niccolascassel/saorafael/README.md

saorafael
=========

São Rafael allotment's projects
