niccolascassel/saorafael/Documentation/ART_ São_Rafael_Nova.pdf

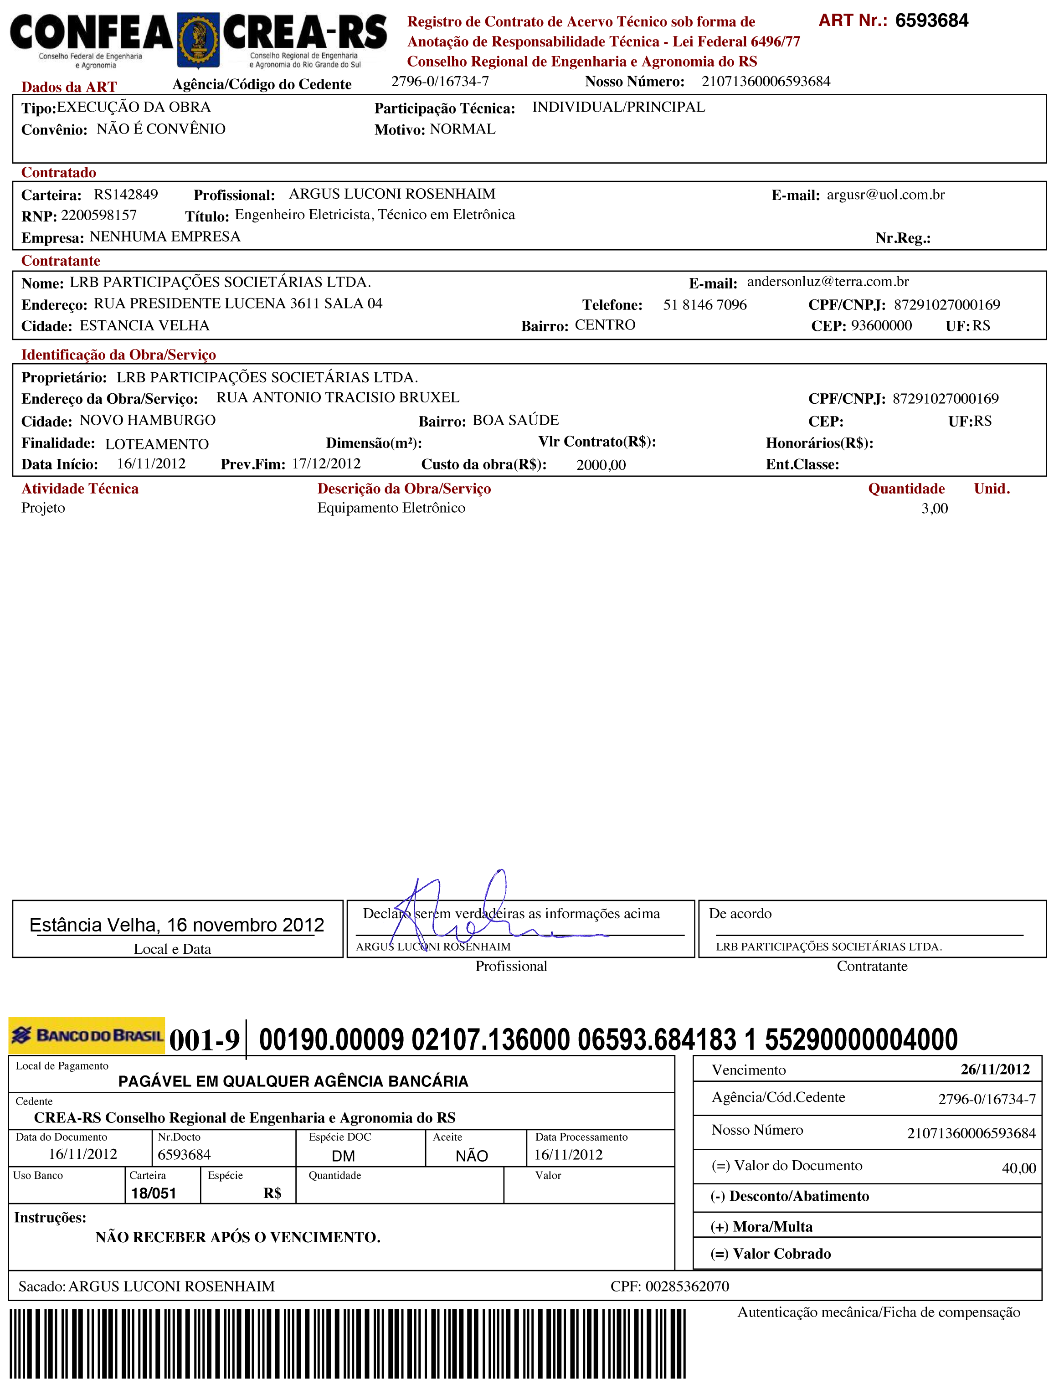
[picture p7: page 1]
