niccolascassel/saorafael/Documentation/Sewage III/Carga Instalada.xlsx

Tipo | Tensão Nominal | Tipo de Rede | Potência Nominal | Quantidade | Potência Total
Lâmpada Compacta | 220Vac | Monofásica | 100 W | 2 | 200 W
Lâmpada de Vapor Sódio | 220Vac | Monofásica | 0.50 kW | 19 | 9.50 kW
Tomada de Uso Geral | 220Vac | Monofásica | 300 W | 3 | 900 W
Painel de Acionamento | 380Vac | Trifásica | 1.50 kW | 5 | 7.50 kW
Misturador Submerso | 380Vac | Trifásica | 2.76 kW | 2 | 5.52 kW
Bomba Helicoidal | 380Vac | Trifásica | 1.42 kW | 1 | 1.42 kW
Bomba Centrífuga Submersível | 380Vac | Trifásica | 6.65 kW | 2 | 13.30 kW
Soprador | 380Vac | Trifásica | 17.73 kW | 1 | 17.73 kW
Bomba Dosadora com Diafragma | 380Vac | Trifásica | 0.45 kW | 2 | 0.90 kW
 |  |  |  | Carga Total Instalada | 56.97 kW
* A potência nominal dos motores foi alculada usando a tabela de rendimento e fator de potência da WEG
