niccolascassel/saorafael/Documentation/Sewage I & II/Carga Instalada - Desatualizada.xlsx

Tipo | Tensão Nominal | Tipo de Rede | Potência Nominal | Quantidade | Potência Total
Lâmpada Compacta | 220Vac | Monofásica | 100 W | 2 | 200 W
Lâmpada de Vapor Sódio | 220Vac | Monofásica | 0.50 kW | 9 | 4.50 kW
Tomada de Uso Geral | 220Vac | Monofásica | 300 W | 3 | 900 W
Painel de Acionamento | 380Vac | Trifásica | 1.50 kW | 5 | 7.50 kW
Misturador Submerso | 380Vac | Trifásica | 2.76 kW | 1 | 2.76 kW
Bomba Helicoidal | 380Vac | Trifásica | 0.90 kW | 1 | 0.90 kW
Bomba Centrífuga Submersível | 380Vac | Trifásica | 3.68 kW | 2 | 7.36 kW
Soprador | 380Vac | Trifásica | 10.77 kW | 1 | 10.77 kW
Bomba Dosadora com Diafragma | 380Vac | Trifásica | 0.45 kW | 2 | 0.90 kW
 |  |  |  | Carga Total Instalada | 35.79 kW
* A potência nominal dos motores foi alculada usando a tabela de rendimento e fator de potência da WEG
