niccolascassel/saorafael/(list of files, cad)

Other CAD files:
Drawings/Sewage I & II/Prancha 03 - São Rafael - Unifilar Alimentação Painéis e Motores.dwg
Drawings/Sewage III/Prancha 09 - São Rafael - Diagramas.dwg
Drawings/Sewage/Prancha 02 - São Rafael - Unifilar Alimentação Painéis e Motores.dwg
Drawings/Supply/Prancha 07 - São Rafael - SPDA do Reservatório.dwg
Drawings/Sewage I & II/Prancha 06 - São Rafael - Painel Sopradores.dwg
Drawings/Sewage III/Prancha 05 - São Rafael - Painel Bomba Recirculação e Misturadores.dwg
Drawings/Sewage/Prancha 04 - São Rafael - Painel Bomba Recirculação e Misturador.dwg
Drawings/Supply/Prancha 02 - São Rafael - Layout QGBT.dwg
Drawings/Sewage I & II/Prancha 02 - São Rafael - Entrada de Rede e Aterramento.dwg
Drawings/Sewage III/Prancha 07 - São Rafael - Painel Bombas Elevação.dwg
Drawings/Sewage/Prancha 06 - São Rafael - Painel Bombas Elevação.dwg
Drawings/Supply/Prancha 04 - São Rafael - Posição, Fixação e Aterramento.dwg
Drawings/Sewage I & II/Prancha 05 - São Rafael - Painel Bomba Recirculação e Misturador.dwg
Drawings/Sewage III/Prancha 04 - São Rafael - Painéis Bombas Dosadoras.dwg
Drawings/Sewage/Prancha 05 - São Rafael - Painel Sopradores.dwg
Drawings/Supply/Prancha 05 - São Rafael - Transdutores de Pressão.dwg
Drawings/Sewage I & II/Prancha 10 - São Rafael - Detalhamentos das Instalações dos Motores.dwg
Drawings/Sewage III/Prancha 08 - São Rafael - Diagrama Unifilar Simplificado.dwg
Drawings/Sewage/Prancha 01 - São Rafael - Entrada de Rede e Aterramento.dwg
Drawings/Supply/Prancha 06 - São Rafael - Instalação Sensor Nível e Painel do Reservatório.dwg
Drawings/Sewage I & II/Prancha 01 - São Rafael - Situação e Entradas de Energia.dwg
Drawings/Sewage III/Prancha 06 - São Rafael - Painel Sopradores.dwg
Drawings/Sewage/Prancha 03 - São Rafael - Painéis Bombas Dosadoras.dwg
Drawings/Supply/Prancha 01 - São Rafael - Esquema QGBT.dwg
Drawings/Sewage I & II/Prancha 04 - São Rafael - Painéis Bombas Dosadoras.dwg
Drawings/Sewage III/Prancha 10 - São Rafael - Detalhamentos das Instalações dos Motores.dwg
Drawings/Supply/Prancha 03 - São Rafael - Painel Reservatorio.dwg
Drawings/Sewage I & II/Prancha 07 - São Rafael - Painel Bombas Elevação.dwg
Drawings/Sewage III/Prancha 02 - São Rafael - Entrada de Rede e Aterramento.dwg
Drawings/Sewage I & II/Prancha 08 - São Rafael - Diagrama Unifilar Simplificado.dwg
Drawings/Sewage III/Prancha 03 - São Rafael - Unifilar Alimentação Painéis e Motores.dwg
Drawings/Sewage I & II/Prancha 09 - São Rafael - Diagramas.dwg
Drawings/Sewage III/Prancha 11 - São Rafael - SPDA.dwg
Drawings/Sewage III/Prancha 01 - São Rafael - Situação e Entradas de Energia.dwg
