niccolascassel/saorafael/Documentation/Supply/AGUA SAO RAFAEL.pdf

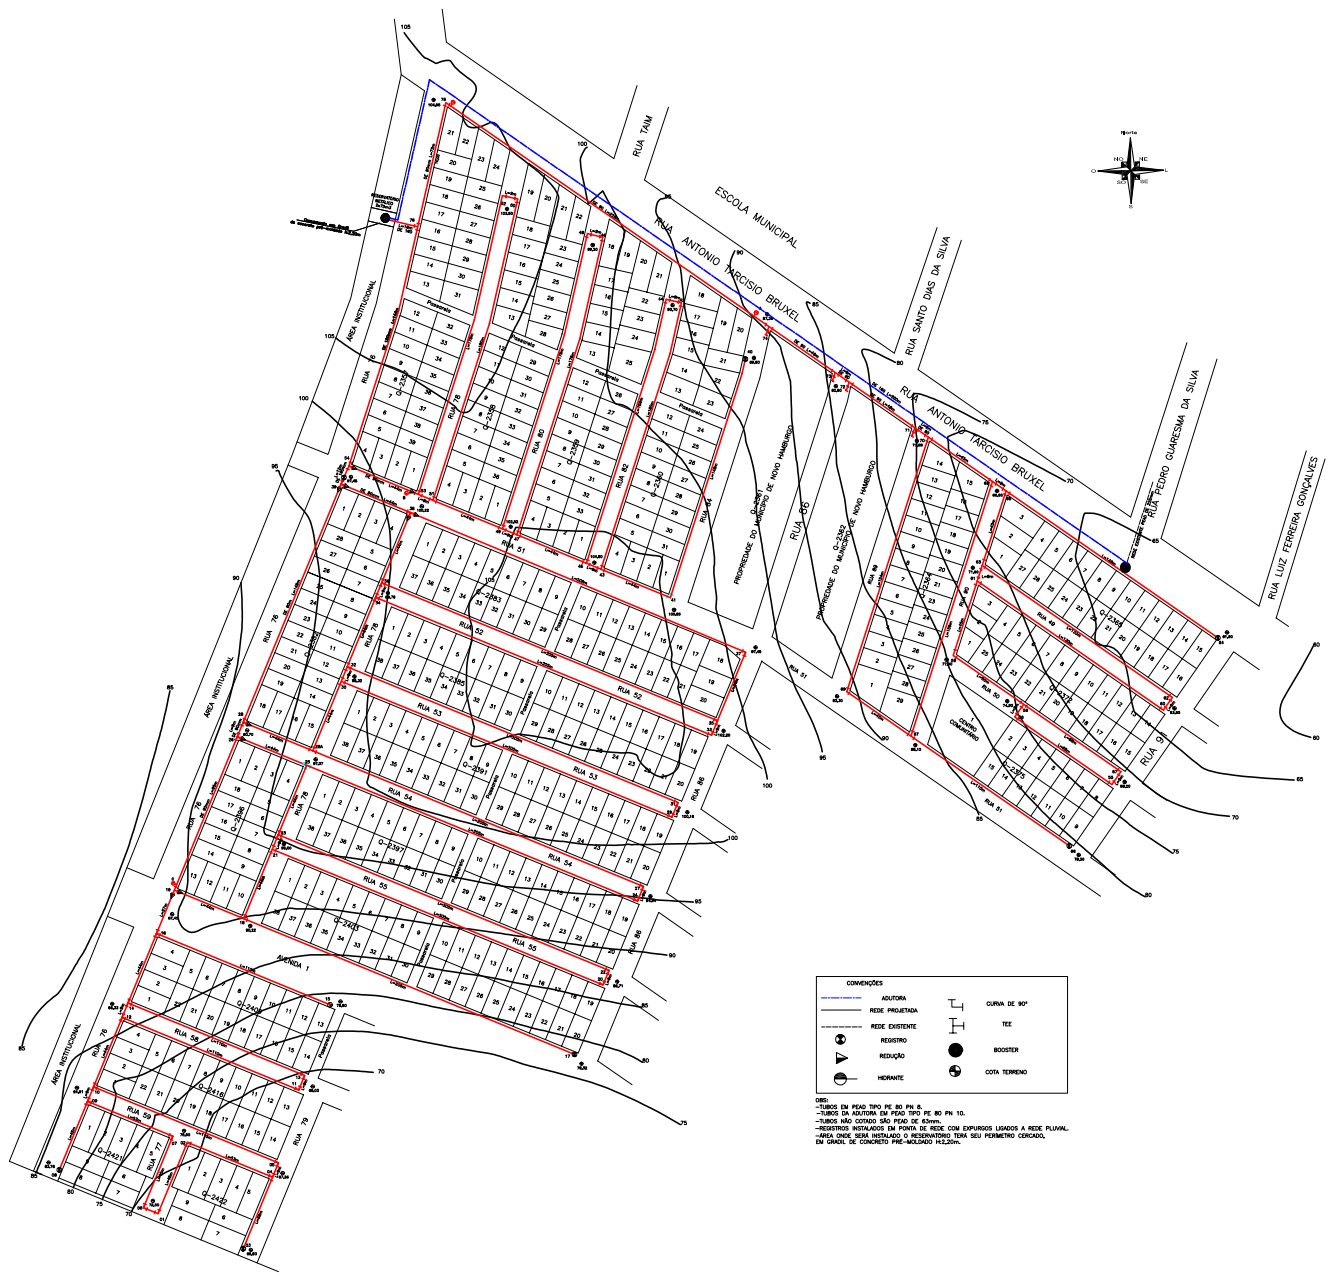
[picture p8: page 1]
