niccolascassel/saorafael/(commit log)

2014-12-17 Drawings - Added documents that were reviewed following the last COMUSA's analysis
    [Prancha 01 - São Rafael - Esquema QGBT - Booster.dwg, Prancha 02 - São Rafael - Layout QGBT - Booster.dwg, Prancha 03 - São Rafael - Painel - Reservatorio.dwg, Prancha 04 - São Rafael - Posição, Fixação e Aterramento - Booster.dwg, Prancha 05 - São Rafael - Transdutores de Pressão - Booster.dwg, Prancha 06 - São Rafael - Instalação Sensor Nível e Painel - Reservatório.dwg, Prancha 07 - São Rafael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]
2014-12-18 Repository reorganization. Separate water supply and sewage treatment projects.
    [Prancha 01 - São Rafael - Entrada de Rede e Aterramento.dwg, Prancha 01 - São Rafael - Esquema QGBT.dwg, Prancha 02 - São Rafael - Layout QGBT.dwg, Prancha 02 - São Rafael - Unifilar Alimentação Painéis e Motores.dwg, Prancha 03 - São Rafael - Painel Reservatorio.dwg, Prancha 03 - São Rafael - Painéis Bombas Dosadoras.dwg, Prancha 04 - São Rafael - Painel Bomba Recirculação e Misturador.dwg, Pran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]
2014-12-18 Re-enumerate drawings, begning with 1
    [Prancha 01 - São Rafael - Entrada de Rede e Aterramento.dwg, Prancha 02 - São Rafael - Unifilar Alimentação Painéis e Motores.dwg, Prancha 03 - São Rafael - Painéis Bombas Dosadoras.dwg, Prancha 04 - São Rafael - Painel Bomba Recirculação e Misturador.dwg, Prancha 05 - São Rafael - Painel Sopradores.dwg, Prancha 06 - São Rafael - Painel Bombas Elevação.dwg]
2014-12-19 Changed CLP for a Compact IO and added manual drives
    [Prancha 03 - São Rafael - Painéis Bombas Dosadoras.dwg]
2014-12-22 Drawings - Sewage - Drawing 03 - Fixed bill of materials and components location
    [Prancha 03 - São Rafael - Painéis Bombas Dosadoras.dwg]
2014-12-22 Drawings - Sewage - Fixed folder name
    [Prancha 01 - São Rafael - Entrada de Rede e Aterramento.dwg, Prancha 02 - São Rafael - Unifilar Alimentação Painéis e Motores.dwg, Prancha 03 - São Rafael - Painéis Bombas Dosadoras.dwg, Prancha 04 - São Rafael - Painel Bomba Recirculação e Misturador.dwg, Prancha 05 - São Rafael - Painel Sopradores.dwg, Prancha 06 - São Rafael - Painel Bombas Elevação.dwg]
2014-12-22 Drawings - Sewage - Drawing 03 - Counter-Door
    [Prancha 03 - São Rafael - Painéis Bombas Dosadoras.dwg]
2014-12-23 Drawings - Sewage - Drawing 4 - Changed the CLP for a Compact IO. Updated schematic and panel layout.
    [Prancha 04 - São Rafael - Painel Bomba Recirculação e Misturador.dwg]
2014-12-23 Drawings - Sewage - Drawing 4 - Updated bill of materials and components location
    [Prancha 04 - São Rafael - Painel Bomba Recirculação e Misturador.dwg]
2014-12-23 Drawings - Sewage - Drawing 3 - Fixed S2 symbol
    [Prancha 03 - São Rafael - Painéis Bombas Dosadoras.dwg]
2015-01-05 Drawings - Sewage - Drawing 4 - Added AD1 in panel layout and bill of materials
    [Prancha 04 - São Rafael - Painel Bomba Recirculação e Misturador.dwg]
2015-01-05 Drawings - Sewage - Drawing 6 - Changed the panel layout to add the AD1 and manual drives
    [Prancha 06 - São Rafael - Painel Bombas Elevação.dwg]
2015-01-05 Drawings - Sewage - Drawing 6 - Fixed location of S1 and DSPs
    [Prancha 06 - São Rafael - Painel Bombas Elevação.dwg]
2015-01-05 Drawings - Sewage - Drawing 6 - Added LEDs to indicate levels A and B
    [Prancha 06 - São Rafael - Painel Bombas Elevação.dwg]
2015-01-06 Drawings - Sewage - Drawing 6 - Fixed schematic and updated bill of materials and list of conectors
    [Prancha 06 - São Rafael - Painel Bombas Elevação.dwg]
2015-01-06 Drawings - Sewage - Drawing 6 - Updated bill of materials, components locations and wire numbers
    [Prancha 06 - São Rafael - Painel Bombas Elevação.dwg]
2015-01-06 Drawings - Sewage - Drawing 4 - Fixed some components identifications
    [Prancha 04 - São Rafael - Painel Bomba Recirculação e Misturador.dwg]
2015-01-06 Drawings - Sewage - Drawing 6 - Fixed some conection numbers
    [Prancha 06 - São Rafael - Painel Bombas Elevação.dwg]
2015-01-06 Drawings - Sewage - Drawing 3 - Fixed some components identifications
    [Prancha 03 - São Rafael - Painéis Bombas Dosadoras.dwg]
2015-01-06 Drawings - Sewage - Drawing 5 - Updated schematic to add communication with other panels and manual drives
    [Prancha 05 - São Rafael - Painel Sopradores.dwg]
2015-01-06 Drawings - Sewage - Drawing 6 - Updated schematic to add auxiliary contacts in main contactors
    [Prancha 06 - São Rafael - Painel Bombas Elevação.dwg]
2015-01-06 Drawings - Sewage - Drawing 3 - Updated schematic to add auxiliary contacts in main contactors
    [Prancha 03 - São Rafael - Painéis Bombas Dosadoras.dwg]
2015-01-07 Drawings - Sewage - Drawing 4 - Updated schematic to add auxiliary contacts in main contactors
    [Prancha 04 - São Rafael - Painel Bomba Recirculação e Misturador.dwg]
2015-01-07 Drawings - Sewage - Drawing 5 - Fixed communication's schematic
    [Prancha 05 - São Rafael - Painel Sopradores.dwg]
2015-01-07 Drawings - Sewage - Drawing 3 -Standardization of motor turn on
    [Prancha 03 - São Rafael - Painéis Bombas Dosadoras.dwg]
2015-01-07 Drawings - Sewage - Drawing 5 - Added power supply with battery and updated bill of materials and panel layout
    [Prancha 05 - São Rafael - Painel Sopradores.dwg]
2015-01-08 Drawings - Sewage - Drawing 2 -Updated the layout of ETE and redrawn the single line diagram
    [Prancha 02 - São Rafael - Unifilar Alimentação Painéis e Motores.dwg]
2015-01-09 Drawings - Sewage - Drawing 2 -Updated the single line diagram and circuits was identified
2015-01-09 Drawings - Sewage - Drawing 3 -Updated wire numbers and cross-sections
    [Prancha 03 - São Rafael - Painéis Bombas Dosadoras.dwg]
2015-01-09 Drawings - Sewage - Drawing 4 -Updated wire numbers and cross-sections and added one more mixer
    [Prancha 04 - São Rafael - Painel Bomba Recirculação e Misturador.dwg]
2015-01-09 Drawings - Sewage - Drawing 5 -Updated wire numbers and cross-sections
    [Prancha 05 - São Rafael - Painel Sopradores.dwg]
2015-01-09 Drawings - Sewage - Drawing 6 -Updated wire numbers and cross-sections
    [Prancha 06 - São Rafael - Painel Bombas Elevação.dwg]
2015-01-12 Documentation - Sewage - Added the specification file and table of installed and demanded charges
    [Carga Demandada.xlsx, Carga Instalada.xlsx]
2015-01-17 Drawings - Sewage - Drawing 4 - Excluded one mixer and related components
    [Prancha 04 - São Rafael - Painel Bomba Recirculação e Misturador.dwg]
2015-01-18 Drawings - Sewage - Drawing 1 - Fixed the dimensions of cables
    [Prancha 01 - São Rafael - Entrada de Rede e Aterramento.dwg]
2015-01-18 Drawings - Sewage - Drawing 5 - Fixed the dimensions of cables
    [Prancha 05 - São Rafael - Painel Sopradores.dwg]
2015-01-18 Drawings - Sewage - Drawing 6 - Fixed the dimensions of cables
    [Prancha 06 - São Rafael - Painel Bombas Elevação.dwg]
2015-01-18 Documentation - Sewage - Updated descriptive text and installed and demand load calculations to new floor plant
    [Carga Demandada.xlsx, Carga Instalada.xlsx]
2015-01-18 Drawings - Sewage - Drawing 6 - Added components to third level of elevation tank
    [Prancha 06 - São Rafael - Painel Bombas Elevação.dwg]
2015-01-18 Drawings - Sewage - Drawing 4 - Fixed wire numbers
    [Prancha 04 - São Rafael - Painel Bomba Recirculação e Misturador.dwg]
2015-01-20 Added documents and drawings of the new ETE
    [Carga Demandada.xlsx, Carga Instalada.xlsx, Prancha 01 - São Rafael - Entrada de Rede e Aterramento.dwg, Prancha 02 - São Rafael - Unifilar Alimentação Painéis e Motores.dwg, Prancha 03 - São Rafael - Painéis Bombas Dosadoras.dwg, Prancha 04 - São Rafael - Painel Bomba Recirculação e Misturador.dwg, Prancha 05 - São Rafael - Painel Sopradores.dwg, Prancha 06 - São Rafael - Painel Bombas Elevação.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]
2015-01-20 Revert "Added documents and drawings of the new ETE"
    This reverts commit d8e05bd61bc3155aeb9ce6ddf27acf804a9b35fc.
    [Carga Demandada.xlsx, Carga Instalada.xlsx, Prancha 01 - São Rafael - Entrada de Rede e Aterramento.dwg, Prancha 02 - São Rafael - Unifilar Alimentação Painéis e Motores.dwg, Prancha 03 - São Rafael - Painéis Bombas Dosadoras.dwg, Prancha 04 - São Rafael - Painel Bomba Recirculação e Misturador.dwg, Prancha 05 - São Rafael - Painel Sopradores.dwg, Prancha 06 - São Rafael - Painel Bombas Elevação.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]
2015-01-20 Changed the name of directories for a better identification of projects
    [Carga Demandada.xlsx, Carga Instalada.xlsx, Prancha 01 - São Rafael - Entrada de Rede e Aterramento.dwg, Prancha 02 - São Rafael - Unifilar Alimentação Painéis e Motores.dwg, Prancha 03 - São Rafael - Painéis Bombas Dosadoras.dwg, Prancha 04 - São Rafael - Painel Bomba Recirculação e Misturador.dwg, Prancha 05 - São Rafael - Painel Sopradores.dwg, Prancha 06 - São Rafael - Painel Bombas Elevação.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]
2015-01-20 Added the documents and drawings to third ETE of the allotment
    [Carga Demandada.xlsx, Carga Instalada.xlsx, Prancha 01 - São Rafael - Entrada de Rede e Aterramento.dwg, Prancha 03 - São Rafael - Painéis Bombas Dosadoras.dwg, Prancha 04 - São Rafael - Painel Bomba Recirculação e Misturador.dwg, Prancha 05 - São Rafael - Painel Sopradores.dwg, Prancha 06 - São Rafael - Painel Bombas Elevação.dwg]
2015-01-22 Updated description text and calculations of installed and demand load with correct engine power
    [Carga Demandada.xlsx, Carga Instalada.xlsx]
2015-01-22 Updated with correct cable dimensions
    [Prancha 01 - São Rafael - Entrada de Rede e Aterramento.dwg]
2015-01-22 Fixed the file name and updated bill of materials and cable dimensions to correct engine power
    [Prancha 04 - São Rafael - Painel Bomba Recirculação e Misturador.dwg, Prancha 04 - São Rafael - Painel Bomba Recirculação e Misturadores.dwg]
2015-01-22 Updated bill of materials and cable dimensions for correct engine power
    [Prancha 05 - São Rafael - Painel Sopradores.dwg, Prancha 06 - São Rafael - Painel Bombas Elevação.dwg]
2015-01-22 Updated service entrance and calculations of installed and demand load for correct engine power
    [Carga Demandada.xlsx, Carga Instalada.xlsx]
2015-01-23 Updated bill of materials and cable dimensions to correct engine power
    [Prancha 01 - São Rafael - Entrada de Rede e Aterramento.dwg, Prancha 02 - São Rafael - Unifilar Alimentação Painéis e Motores.dwg, Prancha 03 - São Rafael - Painéis Bombas Dosadoras.dwg, Prancha 04 - São Rafael - Painel Bomba Recirculação e Misturador.dwg, Prancha 05 - São Rafael - Painel Sopradores.dwg, Prancha 06 - São Rafael - Painel Bombas Elevação.dwg]
2015-01-23 Updated calculations of installed and demand load for correct engine power
    [Carga Demandada.xlsx, Carga Instalada.xlsx]
2015-05-01 Drawings - Sewage - Drawing 2 - Added grounding points
    [Prancha 02 - São Rafael - Unifilar Alimentação Painéis e Motores.dwg]
2015-05-01 Drawings - Sewage - Drawing 1 - Added link extension
    [Prancha 01 - São Rafael - Entrada de Rede e Aterramento.dwg]
2015-05-01 Drawings - Sewage - Drawing 3 - Fixed wire to normal open of EM1
    [Prancha 03 - São Rafael - Painéis Bombas Dosadoras.dwg]
2015-05-01 Drawings - Sewage - Drawing 3 - Added interlock of BT1 and indication of operation mode selection
    [Prancha 03 - São Rafael - Painéis Bombas Dosadoras.dwg]
2015-05-01 Drawings - Sewage - Drawing 3 - Added relay phase supervisor
    [Prancha 03 - São Rafael - Painéis Bombas Dosadoras.dwg]
2015-05-01 Drawings - Sewage - Drawing 3 - Fixed bill of materials and color of pump drive LED
    [Prancha 03 - São Rafael - Painéis Bombas Dosadoras.dwg]
2015-05-01 Drawings - Sewage - Drawing 3 - Fixed wire numbers
    [Prancha 03 - São Rafael - Painéis Bombas Dosadoras.dwg]
2015-05-01 Drawings - Sewage - Drawing 3 - Change power supply for an uninterrupted power supply
    [Prancha 03 - São Rafael - Painéis Bombas Dosadoras.dwg]
2015-05-01 Drawings - Sewage - Drawing 4 - Added relay phase supervisor and interlock for BT1 and BT2
    [Prancha 04 - São Rafael - Painel Bomba Recirculação e Misturador.dwg]
2015-05-01 Drawings - Sewage - Drawing 4 - Fixed cross-section of neutral wire
    [Prancha 04 - São Rafael - Painel Bomba Recirculação e Misturador.dwg]
2015-05-01 Drawings - Sewage - Drawing 4 - Change power supply for an uninterrupted power supply
    [Prancha 04 - São Rafael - Painel Bomba Recirculação e Misturador.dwg]
2015-05-01 Drawings - Sewage - Drawing 4 - Added tags to identify hour meters
    [Prancha 04 - São Rafael - Painel Bomba Recirculação e Misturador.dwg]
2015-05-01 Drawings - Sewage - Drawing 4 - Fixed layout with RST1 and BAT1
    [Prancha 04 - São Rafael - Painel Bomba Recirculação e Misturador.dwg]
2015-05-01 Drawings - Sewage - Drawing 3 - Fixed layout with RST1 and BAT1
    [Prancha 03 - São Rafael - Painéis Bombas Dosadoras.dwg]
2015-05-01 Drawings - Sewage - Drawing 4 - Fixed the recirculation pump remote drive
    [Prancha 04 - São Rafael - Painel Bomba Recirculação e Misturador.dwg]
2015-05-01 Drawings - Sewage - Drawing 4 - Fixed the manual drive of frequency inverter
    [Prancha 04 - São Rafael - Painel Bomba Recirculação e Misturador.dwg]
2015-05-01 Drawings - Sewage - Drawing 3 - Fixed layout with tags AUTO/MANUAL
    [Prancha 03 - São Rafael - Painéis Bombas Dosadoras.dwg]
2015-05-01 Drawings - Sewage - Drawing 4- Fixed layout with tags AUTO/MANUAL
    [Prancha 04 - São Rafael - Painel Bomba Recirculação e Misturador.dwg]
2015-05-01 Drawings - Sewage - Drawing 5- Fixed layout with tags AUTO/MANUAL
    [Prancha 05 - São Rafael - Painel Sopradores.dwg]
2015-05-01 Drawings - Sewage - Drawing 5- Fixed layout with tags for identification of hour meters
    [Prancha 05 - São Rafael - Painel Sopradores.dwg]
2015-05-01 Drawings - Sewage - Drawing 5- Fixed bill of materials. Added a description for RD1.
    [Prancha 05 - São Rafael - Painel Sopradores.dwg]
2015-05-01 Drawings - Sewage - Drawing 5- Added interlock for BT1 and BT2
    [Prancha 05 - São Rafael - Painel Sopradores.dwg]
2015-05-01 Drawings - Sewage - Drawing 5- Added relay phase supervisor
    [Prancha 05 - São Rafael - Painel Sopradores.dwg]
2015-05-01 Drawings - Sewage - Drawing 5- Fixed the neutral and grounding wires section
    [Prancha 05 - São Rafael - Painel Sopradores.dwg]
2015-05-02 Drawings - Sewage - Drawing 4- Fixed manual recirculation pump drive, wire number and bill of materials
    [Prancha 04 - São Rafael - Painel Bomba Recirculação e Misturador.dwg]
2015-05-02 Drawings - Sewage - Drawing 5- Fixed the blowers manual drive
    [Prancha 05 - São Rafael - Painel Sopradores.dwg]
2015-05-02 Drawings - Sewage - Drawing 5- Fixed the wire numbers
    [Prancha 05 - São Rafael - Painel Sopradores.dwg]
2015-05-02 Drawings - Sewage - Drawing 6- Added identification to S2 positions
    [Prancha 06 - São Rafael - Painel Bombas Elevação.dwg]
2015-05-02 Drawings - Sewage - Drawing 6- Changed the power supply for a model uninterrupted
    [Prancha 06 - São Rafael - Painel Bombas Elevação.dwg]
2015-05-02 Drawings - Sewage - Drawing 6- Added tags for identification of hour meters
    [Prancha 06 - São Rafael - Painel Bombas Elevação.dwg]
2015-05-02 Drawings - Sewage - Drawing 6- Fixed the sections of neutral and grounding wires
    [Prancha 06 - São Rafael - Painel Bombas Elevação.dwg]
2015-05-02 Drawings - Sewage - Drawing 6- Added identification for C level
    [Prancha 06 - São Rafael - Painel Bombas Elevação.dwg]
2015-05-02 Drawings - Sewage - Drawing 6- Fixed connector list identifications
    [Prancha 06 - São Rafael - Painel Bombas Elevação.dwg]
2015-05-02 Drawings - Sewage - Drawing 3- Added BT1 on bill of materials
    [Prancha 03 - São Rafael - Painéis Bombas Dosadoras.dwg]
2015-05-02 Drawings - Sewage - Added Drawing 7. Location and Situation.
    [Prancha 07 - São Rafael - Situação.dwg]
2015-05-02 Drawings - Sewage - Drawing 6- Added relay phase supervisor
    [Prancha 06 - São Rafael - Painel Bombas Elevação.dwg]
2015-05-03 Drawings - Sewage - Drawing 6- Added interlock for BT1, BT2 and BT3
    [Prancha 06 - São Rafael - Painel Bombas Elevação.dwg]
2015-05-04 Documentation - Sewage - Description of communication
    [Comunicação.xlsx]
2015-05-18 Drawings - Sewage - Drawing 2- Fixed some issues of single digram
    [Prancha 02 - São Rafael - Unifilar Alimentação Painéis e Motores.dwg]
2015-05-24 Added schematic to distribution panels
    [Prancha 08 - São Rafael - QSBT 1.dwg, Prancha 09 - São Rafael - QSBT 2.dwg]
2015-05-24 Reorganized the order of drawings
    [Prancha 01 - São Rafael - Entrada de Rede e Aterramento.dwg, Prancha 01 - São Rafael - Situação e Entradas de Energia.dwg, Prancha 02 - São Rafael - Entrada de Rede e Aterramento.dwg, Prancha 03 - São Rafael - Painéis Bombas Dosadoras.dwg, Prancha 03 - São Rafael - Unifilar Alimentação Painéis e Motores.dwg, Prancha 04 - São Rafael - Painel Bomba Recirculação e Misturador.dwg, Prancha 04 - São Ra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]
2015-05-26 Drawings - Sewage - Drawing 3- Fixed some issues of single digram
    [Prancha 03 - São Rafael - Unifilar Alimentação Painéis e Motores.dwg]
2015-05-26 Changed the names QSBT 1 and QSBT 2 to QGBT and QSBT respectively
    [Prancha 08 - São Rafael - QGBT.dwg, Prancha 08 - São Rafael - QSBT 1.dwg, Prancha 09 - São Rafael - QSBT 2.dwg, Prancha 09 - São Rafael - QSBT.dwg]
2015-05-26 Drawings - Sewage - Drawing 3- Added Level Sensor for Elevation of Sewage
    [Prancha 03 - São Rafael - Unifilar Alimentação Painéis e Motores.dwg]
2015-05-31 Reorganized the structure of drawing files and applied the revision 01
    [Prancha 01 - São Rafael - Entrada de Rede e Aterramento.dwg, Prancha 02 - São Rafael - Entrada de Rede e Aterramento.dwg, Prancha 03 - São Rafael - Painéis Bombas Dosadoras.dwg, Prancha 03 - São Rafael - Unifilar Alimentação Painéis e Motores.dwg, Prancha 04 - São Rafael - Painel Bomba Recirculação e Misturadores.dwg, Prancha 04 - São Rafael - Painéis Bombas Dosadoras.dwg, Prancha 05 - São Rafael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]
2015-06-09 Added drawings to QGBT and QSBT panels
    [Prancha 08 - São Rafael - QGBT.dwg, Prancha 09 - São Rafael - QSBT.dwg]
2015-06-09 Drawings - Sewage - Drawing 5 - Fixed the name of Panel of Mixers and Recirculation Pump
    [Prancha 05 - São Rafael - Painel Bomba Recirculação e Misturadores.dwg]
2015-06-09 Drawings - Sewage - Added situation drawing
    [Prancha 01 - São Rafael - Situação e Entradas de Energia.dwg]
2015-06-09 Drawings - Sewage - Drawing 3 - Fixed the single diagram
    [Prancha 03 - São Rafael - Unifilar Alimentação Painéis e Motores.dwg]
2015-06-10 Drawings - Sewage - Drawing 6 - Fixed the cable sections
    [Prancha 06 - São Rafael - Painel Sopradores.dwg]
2015-06-10 Drawings - Sewage - Drawing 7 - Fixed the cable sections
    [Prancha 07 - São Rafael - Painel Bombas Elevação.dwg]
2015-06-10 Fixed the cable sections
    [Prancha 08 - São Rafael - QGBT.dwg, Prancha 09 - São Rafael - QSBT.dwg]
2015-09-12 Drawings - Sewage - Drawing 4 - Added phase fault signalization and surge protector to 485 bus
    [Prancha 04 - São Rafael - Painéis Bombas Dosadoras.dwg]
2015-09-12 Drawings - Sewage - Drawing 5 - Changed the position of H1, added surge protector to 485 bus and added identification for S2 positions
    [Prancha 05 - São Rafael - Painel Bomba Recirculação e Misturador.dwg]
2015-09-12 Drawings - Sewage - Drawing 4 - protector to 485 bus on internal panel layout
    [Prancha 04 - São Rafael - Painéis Bombas Dosadoras.dwg]
2015-09-12 Drawings - Sewage - Drawing 5 - Fixed bill of materials and added the surge protector for 485 bus on internal panel layout
    [Prancha 05 - São Rafael - Painel Bomba Recirculação e Misturador.dwg]
2015-09-12 Drawings - Sewage - Drawing 6 - Fixed according COMUSA's request
    [Prancha 06 - São Rafael - Painel Sopradores.dwg]
2015-09-12 Drawings - Sewage - Fixed according COMUSA's request
    [Prancha 05 - São Rafael - Painel Bomba Recirculação e Misturador.dwg, Prancha 06 - São Rafael - Painel Sopradores.dwg, Prancha 07 - São Rafael - Painel Bombas Elevação.dwg]
2015-10-31 Updated structure of drawings according revision 8
    [Prancha 08 - São Rafael - Diagrama Unifilar Simplificado.dwg, Prancha 08 - São Rafael - QGBT.dwg, Prancha 09 - São Rafael - Diagramas.dwg, Prancha 09 - São Rafael - QSBT.dwg]
2015-10-31 Fixed according COMUSA's request
    [Prancha 04 - São Rafael - Painéis Bombas Dosadoras.dwg, Prancha 05 - São Rafael - Painel Bomba Recirculação e Misturador.dwg, Prancha 06 - São Rafael - Painel Sopradores.dwg, Prancha 07 - São Rafael - Painel Bombas Elevação.dwg]
2015-10-31 Updated to revision 8 with following changes:
    - Updated address and descriptions for communication
    - Updated installed load and respondent
    - Specifications for distribution boards
    - Updated specification for power input
2015-10-31 Needs to be updated according revision 8
    [Carga Demandada - Desatualizada.xlsx, Carga Instalada - Desatualizada.xlsx, Comunicação - Desatualizada.xlsx]
2015-10-31 Fixed according COMUSA's request for revision 2
    [Prancha 01 - São Rafael - Situação e Entradas de Energia.dwg, Prancha 02 - São Rafael - Entrada de Rede e Aterramento.dwg, Prancha 03 - São Rafael - Unifilar Alimentação Painéis e Motores.dwg, Prancha 04 - São Rafael - Painéis Bombas Dosadoras.dwg, Prancha 05 - São Rafael - Painel Bomba Recirculação e Misturadores.dwg, Prancha 06 - São Rafael - Painel Sopradores.dwg, Prancha 07 - São Rafael - Pai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]
2015-10-31 Drawings - Sewage - Drawing 4 - Added surge protection for RS-485 and signalization of phase fault on frontal of panel
    [Prancha 04 - São Rafael - Painéis Bombas Dosadoras.dwg]
2015-10-31 Drawings - Sewage - Drawing 5 - Added surge protection for RS-485, fixed the identification of contact K2 close H2 and added identification of positions of S2
    [Prancha 05 - São Rafael - Painel Bomba Recirculação e Misturadores.dwg]
2015-10-31 Drawings - Sewage - Drawing 6 - Added surge protection for RS-485, fixed the operation of blowers according COMUSA's request and added identification of position of S2 and S3
    [Prancha 06 - São Rafael - Painel Sopradores.dwg]
2015-10-31 Drawings - Sewage - Drawing 4 - Fixed the identification of positions of S2
    [Prancha 04 - São Rafael - Painéis Bombas Dosadoras.dwg]
2015-10-31 Drawings - Sewage - Drawing 4 - Added DSP5 on panel layout
    [Prancha 04 - São Rafael - Painéis Bombas Dosadoras.dwg]
2015-10-31 Drawings - Sewage - Drawing 5 - Added DSP5 on panel layout
    [Prancha 05 - São Rafael - Painel Bomba Recirculação e Misturadores.dwg]
2015-10-31 Drawings - Sewage - Drawing 7 - Fixed the identification of relays contacts, added surge protection for RS-485 and added selector switch for the reserve pump
    [Prancha 07 - São Rafael - Painel Bombas Elevação.dwg]
2015-10-31 Excluded the drawings of QGBT and QSBT. Added the drawing to simplified single line diagram
    [Prancha 08 - São Rafael - Diagrama Unifilar Simplificado.dwg, Prancha 08 - São Rafael - QGBT.dwg, Prancha 09 - São Rafael - Diagramas.dwg, Prancha 09 - São Rafael - QSBT.dwg, Prancha 10 - São Rafael - Diagramas.dwg]
2015-11-01 Drawings - Sewage - Drawing 5 - Fixed AD1 inputs
    [Prancha 05 - São Rafael - Painel Bomba Recirculação e Misturadores.dwg]
2015-11-28 Removed relay that signaled phase fault to K2
    [Prancha 05 - São Rafael - Painel Bomba Recirculação e Misturador.dwg]
2015-11-28 Drawings - Sewage - Drawing 6 - Removed de signalization of phase fault for emergency relay
    [Prancha 06 - São Rafael - Painel Sopradores.dwg]
2015-11-28 Drawings - Sewage - Drawing 8 - Removed the power circuit of fans from blower panels. The fans will be supplied by the QSBT panel.
    [Prancha 08 - São Rafael - Diagrama Unifilar Simplificado.dwg]
2015-11-28 Drawings - Sewage - Drawing 7 - Added RL4 and RL5 to ensure that the reserve pump doesn't be triggered in manual mode if the switch S3 isn't selecting it
    [Prancha 07 - São Rafael - Painel Bombas Elevação.dwg]
2015-11-28 Drawings - Sewage - Drawing 7 - Exchanged the model of K4, K5 and K6 to use the NO contacts to prevent the cavitation of pumps
    [Prancha 07 - São Rafael - Painel Bombas Elevação.dwg]
2015-11-28 Final adjusts of REV08
    [Prancha 01 - São Rafael - Situação e Entradas de Energia.dwg, Prancha 02 - São Rafael - Entrada de Rede e Aterramento.dwg, Prancha 03 - São Rafael - Unifilar Alimentação Painéis e Motores.dwg]
2015-11-29 Standardization of the connections of phase fault relay and emergency relay
    [Prancha 04 - São Rafael - Painéis Bombas Dosadoras.dwg, Prancha 05 - São Rafael - Painel Bomba Recirculação e Misturador.dwg, Prancha 06 - São Rafael - Painel Sopradores.dwg, Prancha 07 - São Rafael - Painel Bombas Elevação.dwg]
2015-11-29 Drawings - Sewage - Drawing 7 - Added connectors to flow meter of Pasrshal rail
    [Prancha 07 - São Rafael - Painel Bombas Elevação.dwg]
2015-11-29 Drawings - Sewage - Drawing 7 - Fixed the description of AD1
    [Prancha 07 - São Rafael - Painel Bombas Elevação.dwg]
2015-11-29 Drawings - Sewage - Drawing 8 - Fixed the circuit breakers values
    [Prancha 08 - São Rafael - Diagrama Unifilar Simplificado.dwg]
2015-11-29 Drawings - Sewage - Drawing 8 - Fixed the components of energy entry and the demand calculation
    [Prancha 08 - São Rafael - Diagrama Unifilar Simplificado.dwg]
2015-11-29 Added drawings of electric motors detailing
    [Prancha 10 - São Rafael - Detalhamentos das Instalações dos Motores.dwg]
2015-11-29 Drawings - Sewage - Drawing 10 - Added detailing for dosing pumps
    [Prancha 10 - São Rafael - Detalhamentos das Instalações dos Motores.dwg]
2015-12-01 Fixed final issue of Rev09
    [Prancha 02 - São Rafael - Entrada de Rede e Aterramento.dwg, Prancha 03 - São Rafael - Unifilar Alimentação Painéis e Motores.dwg, Prancha 04 - São Rafael - Painéis Bombas Dosadoras.dwg, Prancha 05 - São Rafael - Painel Bomba Recirculação e Misturador.dwg, Prancha 06 - São Rafael - Painel Sopradores.dwg, Prancha 07 - São Rafael - Painel Bombas Elevação.dwg, Prancha 08 - São Rafael - Diagrama Unif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]
2015-12-01 Drawings - Sewage - Drawing 4 - Added connector to flow meter of Parshal rail and standardization of connections between RST and RLEM
    [Prancha 04 - São Rafael - Painéis Bombas Dosadoras.dwg]
2015-12-01 Drawings - Sewage - Drawing 4 - Fixed the input of flow meter reading
    [Prancha 04 - São Rafael - Painéis Bombas Dosadoras.dwg]
2015-12-01 Drawings - Sewage - Drawing 4 - Fixed the revision number
    [Prancha 04 - São Rafael - Painéis Bombas Dosadoras.dwg]
2015-12-01 Drawings - Sewage - Drawing 5 - Excluded the relay that powered off K3 to prevent bad issues with frequency inverter
    [Prancha 05 - São Rafael - Painel Bomba Recirculação e Misturadores.dwg]
2015-12-01 Drawings - Sewage - Drawing 6 - Fixed the connection between RST and RLEM to prevent bad issues with frequency inverter and removed NC contact of S2 (obsolete)
    [Prancha 06 - São Rafael - Painel Sopradores.dwg]
2015-12-01 Drawings - Sewage - Drawing 4 - Fixed the panel layout
    [Prancha 04 - São Rafael - Painéis Bombas Dosadoras.dwg]
2015-12-01 Drawings - Sewage - Drawing 5 - Fixed the panel layout
    [Prancha 05 - São Rafael - Painel Bomba Recirculação e Misturadores.dwg]
2015-12-02 Added detailing of motors installations
    [Prancha 10 - São Rafael - Detalhamentos das Instalações dos Motores.dwg]
2015-12-02 Drawings - Sewage - Drawing 7 - Added RL13 and RL14 to disable the reserve pump following the S3 position.
    Added NO contacts of K4 and K5 to avoid pumps cavitation.
    Added connectors to flow meter of Parshal rail.
    [Prancha 07 - São Rafael - Painel Bombas Elevação.dwg]
2015-12-03 Drawings - Sewage - Drawing 8 - Fixed the value of circuit breakers and wire sections
    [Prancha 08 - São Rafael - Diagrama Unifilar Simplificado.dwg]
2016-02-23 Drawings - Sewage - Drawing 5 - Fixed issues related with revision 04
    [Prancha 05 - São Rafael - Painel Bomba Recirculação e Misturadores.dwg]
2016-02-23 Drawings - Sewage - Drawing 4 - Fixed the description of surge protection device for RS-485
    [Prancha 04 - São Rafael - Painéis Bombas Dosadoras.dwg]
2016-02-23 Drawings - Sewage - Drawing 6 - Fixed the connections with phase fault relay, fixed the identification of RL3 contact and added a HMI
    [Prancha 06 - São Rafael - Painel Sopradores.dwg]
2016-02-23 Drawings - Sewage - Drawing 6 - Fixed wire numbers
    [Prancha 06 - São Rafael - Painel Sopradores.dwg]
2016-02-23 Drawings - Sewage - Drawing 7 - Fixed wire numbers, fixed connection of phase fault relay and added protections to pump drives
    [Prancha 07 - São Rafael - Painel Bombas Elevação.dwg]
2016-02-23 Drawings - Sewage - Drawing 7 - Fixed wire numbers and interlock for pump drives
    [Prancha 07 - São Rafael - Painel Bombas Elevação.dwg]
2016-02-24 Drawings - Sewage - Drawings 6 and 8 - Added components to drive external fans, into the blowers panel
    [Prancha 06 - São Rafael - Painel Sopradores.dwg, Prancha 08 - São Rafael - Diagrama Unifilar Simplificado.dwg]
2016-02-24 Drawings - Sewage - Drawing 9 - Fixed the description of elevation pumps control, according the changes made on panel drawing
    [Prancha 09 - São Rafael - Diagramas.dwg]
